joshfriend/wwvb_shield/EAGLE/Layout.jpg

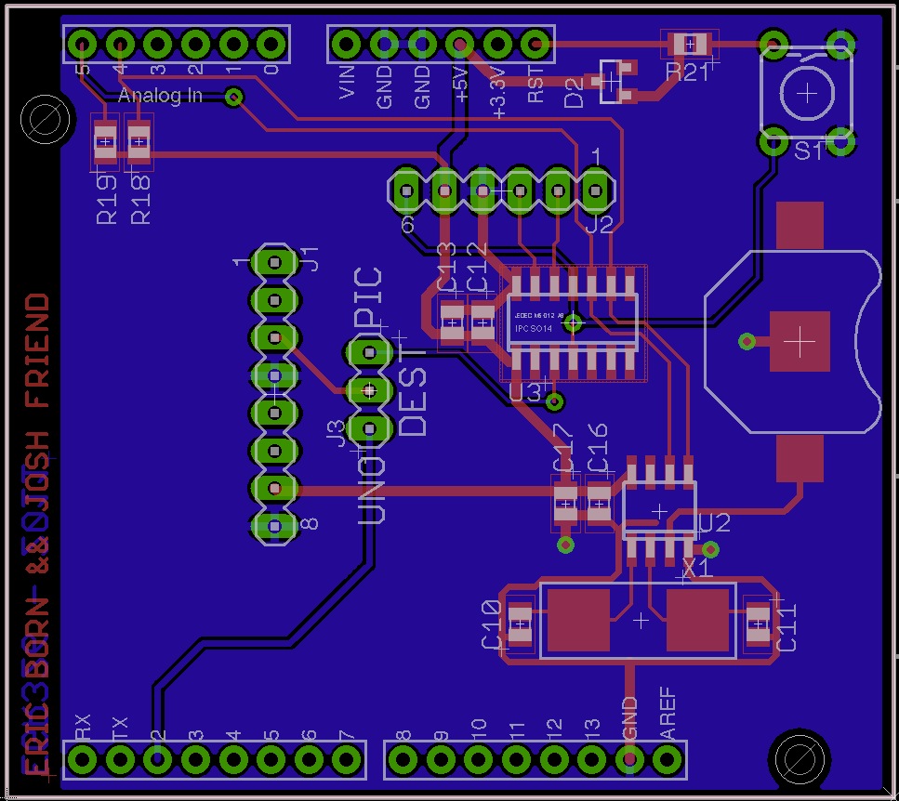
EAGLE/Layout.jpg
