joshfriend/wwvb_shield/README

This is the GIT repository for the Atomic Clock Arduino Shield created by Eric Born and Josh Friend for the EGR326 Junior Design Project at GVSU School of Engineering.

This repo contains all EAGLE schematic and board files as well as GERBERs and source code files used in the project.
