joshfriend/wwvb_shield/BOM/WWVB Shield BOM.xlsx

EGR326 - 901
WWVB Receiver Shield BOM
Internal Components
Eric Born and Josh Friend
REVISION B02
Description | Manufacturer | MFR PN | Vendor | Vendor PN | Package Type | REFDES | QTY | Unit Price (QTY1) | Total Cost (QTY 1) | Notes | Datasheet
IC MCU 8BIT FLASH 14SOIC | Microchip | PIC16F1823-I/SL | DigiKey | PIC16F1823-I/SL-ND (http://search.digikey.com/us/en/products/PIC16F1823-I%2FSL/PIC16F1823-I%2FSL-ND/2258580) | SOIC | U1 | 1 | $1.38 | $1.38 |  | http://ww1.microchip.com/downloads/en/DeviceDoc/41413B.pdf
IC RTCC 64B SRAM GP 8-SOIC | Microchip | MCP7940N | DigiKey | MCP7940N-I/SN-ND (http://search.digikey.com/scripts/DkSearch/dksus.dll?Detail&name=MCP7940N-I/SN-ND) | SOIC | U2 | 1 | $1.04 | $1.04 |  | http://ww1.microchip.com/downloads/en/DeviceDoc/25010B.pdf
HOLDER COIN CELL 12MM SMD | MPD | BK-885-TR | DigiKey | BK-885CT-ND (http://search.digikey.com/us/en/products/BK-885-TR/BK-885CT-ND/755448) | SMD | BAT1 | 1 | $0.48 | $0.48 |  | http://www.memoryprotectiondevices.com/datasheets/BK-885-datasheet.pdf (http://www.onsemi.com/pub_link/Collateral/MMBF4391LT1-D.PDF)
DIODE SCHOTTKY 200MA 30V SOT-23 | Comchip | BAT54-G | DigiKey | 641-1321-1-ND (http://search.digikey.com/us/en/products/BAT54-G/641-1321-1-ND/1979686) | SOT-23 | D1 | 1 | $0.35 | $0.35 |  | http://comchipt.ipower.com/docs/BAT54.pdf
CRYSTAL 32.7680KHZ 12.5PF SMD | Epson | MC-405 32.7680K-A0:ROHS | DigiKey | SER2405CT-ND (http://search.digikey.com/us/en/products/MC-405%2032.7680K-A0:ROHS/SER2405CT-ND/1532561) | SMD | X1 | 1 | $1.01 | $1.01 |  | http://media.digikey.com/pdf/Data%20Sheets/Epson%20PDFs/MC-306%20,405,%20406.pdf
SPST Mini Pushbutton TH | Omiron | (unknown) | SparkFun | COM-00097 (http://www.sparkfun.com/products/97) | TH | S1 | 1 | $0.35 | $0.35 |  | http://www.sparkfun.com/datasheets/Components/General/00097.jpg
CONN HEADER VERT 3POS .100 TIN | TE Connectivity | 3-644456-3 | DigiKey | A31113-ND (http://search.digikey.com/us/en/products/3-644456-3/A31113-ND/698345) | TH | J3 | 1 | $0.22 | $0.22 |  | http://documents.tycoelectronics.com/commerce/DocumentDelivery/DDEController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
CONN HEADER 6POS .100 R/A TIN | FCI | 68016-406HLF | DigiKey | 609-3327-ND (http://search.digikey.com/us/en/products/68016-406HLF/609-3327-ND/1878461) | TH | J2 | 1 | $0.41 | $0.41 |  | http://portal.fciconnect.com/res/en/pdffiles/doc_search/68015.pdf
CONN FEMALE 8POS .100" R/A TIN | Sullins Con. Solns. | PPTC081LGBN-RC | DigiKey | S5444-ND (http://search.digikey.com/us/en/products/PPTC081LGBN-RC/S5444-ND/775902) | TH | J4 | 1 | $0.90 | $0.90 |  | http://www.sullinscorp.com/drawings/78_P(N)PxCxx1LGBN-RC,_10493-F.pdf
Arduino Stackable Header Kit | (unknown) | (unknown) | SparkFun | PRT-10007 (http://www.sparkfun.com/products/10007) | TH | J1 | 1 | $1.50 | $1.50 |  | http://www.sparkfun.com/datasheets/Prototyping/Connectors/18688.pdf
RES 4.7K OHM 1/8W 1% 0805 SMD | Panasonic | ERJ-6ENF4701V | DigiKey | P4.70KCCT-ND (http://search.digikey.com/us/en/products/ERJ-6ENF4701V/P4.70KCCT-ND/1746872) | 0805 | R3 | 1 | $0.07 | $0.07 |  | http://industrial.panasonic.com/www-data/pdf/AOA0000/AOA0000CE2.pdf
RES 10.0K OHM 1/8W 1% 0805 SMD | Panasonic | ERJ-6ENF1002V | DigiKey | P10.0KCCT-ND (http://search.digikey.com/us/en/products/ERJ-6ENF1002V/P10.0KCCT-ND/119248) | 0805 | R1, R2 | 2 | $0.07 | $0.14 |  | http://industrial.panasonic.com/www-data/pdf/AOA0000/AOA0000CE2.pdf
CAP CER 10PF 50V 5% NP0 0805 | Johanson Dielectric | 500R15N100JV4T | DigiKey | 709-1168-1-ND (http://search.digikey.com/us/en/products/500R15N100JV4T/709-1168-1-ND/1859500) | 0805 | C5, C6 | 2 | $0.04 | $0.09 |  | http://www.johansondielectrics.com/images/stories/surface-mount/smt-mlc/JDI_Surface-Mount_2008-11.pdf
CAP CER 10000PF 50V 10% X7R 0805 | AVX | 08055C103KAT2A | DigiKey | 478-1383-1-ND (http://search.digikey.com/us/en/products/08055C103KAT2A/478-1383-1-ND/564415) | 0805 | C3, C4 | 2 | $0.03 | $0.06 |  | http://www.avx.com/docs/Catalogs/cx7r.pdf
CAP CER 0.1UF 50V Y5V 0805 | Yageo | CC0805ZRY5V9BB104 | DigiKey | 311-1361-1-ND (http://search.digikey.com/us/en/products/CC0805ZRY5V9BB104/311-1361-1-ND/2103145) | 0805 | C1, C2 | 2 | $0.04 | $0.08 |  | http://media.digikey.com/pdf/Data%20Sheets/Yageo%20PDFs/MLCC%20ordering%20code.pdf
PCB | Advanced Circuits |  | Adv. Ckts. | - | - | - | 1 | $5.00 | $5.00
 |  |  |  |  |  |  |  | Total | $13.07
EGR326 - 901
WWVB Receiver Shield BOM
External Components
Eric Born and Josh Friend
REVISION B02
Description | Manufacturer | MFR PN | Vendor | Vendor PN | Package Type | REFDES | QTY | Unit Price (QTY100) | Total Cost (QTY 100) | Notes | Datasheet
CMAX WWVB Reciever | C-MAX Time | CMMR-6P-60 | DigiKey | 561-1014-ND (http://search.digikey.com/us/en/products/CMMR-6P-60/561-1014-ND/761973) | TH | - | 1 | $6.69 | $6.69 |  | http://www.c-max-time.com/downloads/getFile.php?id=542
 |  |  |  |  |  |  |  | Total | $6.69
 |  |  |  |  |  |  |  | GRAND TOTAL | $19.76
