joshfriend/wwvb_shield/EAGLE/WWVB Shield Schematic.pdf

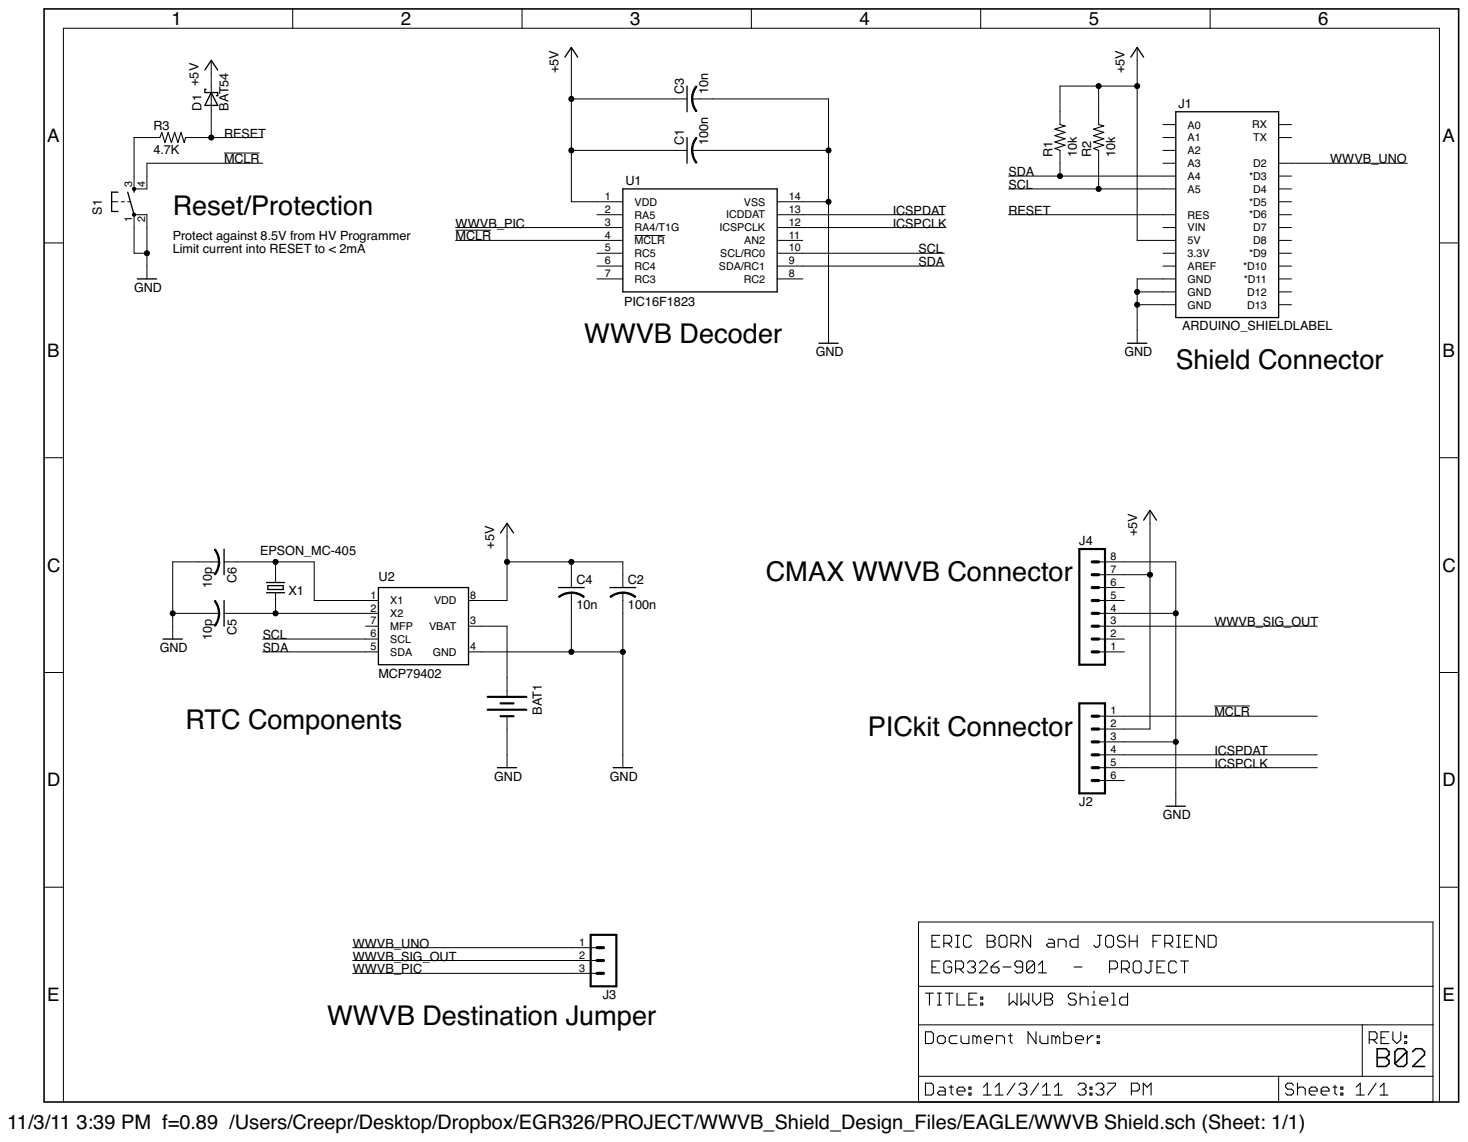
[picture p6: page 1]

Protect against 8.5V from HV Programmer Limit current into RESET to < 2mA

11/3/11 3:39 PM f=0.89 /Users/Creepr/Desktop/Dropbox/EGR326/PROJECT/WWVB_Shield_Design_Files/EAGLE/WWVB Shield.sch (Sheet: 1/1)
