joshfriend/wwvb_shield/CODE/Arduino Sketches/RTC_read/RTC_read.pde

// Date and time functions using a MCP79410N RTC connected via I2C and Wire lib

#include <Wire.h>
#include "RTClib.h"

RTC Clock;

void setup () {
    Serial.begin(9600);
    Wire.begin();
    Clock.begin();
    Clock.set_vbaten(0x01);
    //Clock.adjust(DateTime(__DATE__, __TIME__));
     
    /*
    if (! Clock.isrunning()) {
        Serial.println("RTC is NOT running!");
        // following line sets the RTC to the date & time this sketch was compiled
        Clock.adjust(DateTime(__DATE__, __TIME__));
    }*/
}

void loop () {
    
    DateTime now = Clock.now();
    
    Serial.print(now.year(), DEC);
    Serial.print('/');
    Serial.print(now.month(), DEC);
    Serial.print('/');
    Serial.print(now.day(), DEC);
    Serial.print(' ');
    Serial.print(now.hour(), DEC);
    Serial.print(':');
    Serial.print(now.minute(), DEC);
    Serial.print(':');
    Serial.print(now.second(), DEC);
    Serial.println();
    
    Serial.println();
    delay(1000);
}
