joshfriend/wwvb_shield/(commit log)

2011-10-22 Added pdf of the EAGLE schematic
2011-10-22 updated README and uploaded Bill of Materials"
    [WWVB Shield BOM.xlsx]
2011-10-25 moved all components to top side
    [WWVB Shield.brd, WWVB Shield.sch]
2011-10-25 added mounting hole for antenna (1/8th inch), moved opamp decoupling closer to chip, routed coin cell ground, resized lettering to pass DRC.
    [WWVB Shield.brd, WWVB Shield.sch]
2011-10-25 updated schematic PDF
    [WWVB Shield.sch]
2011-10-26 flipped J1 back to top side of the board. all componenents on top side now (really!)
    [WWVB Shield.brd, WWVB Shield.sch]
2011-10-26 Added reset protection for Arduino against high voltage programming via MCLR.
    [WWVB Shield.brd, WWVB Shield.sch]
2011-10-26 added description of reset protection
    [WWVB Shield.sch]
2011-10-27 updated BOM with reference designators.
    [WWVB Shield BOM.xlsx, WWVB Shield.brd, WWVB Shield.sch]
2011-10-27 added test GERBER files, CAM Processor setup file, and GerbV project settings file
    [WWVB Shield.brd, WWVB Shield.sch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]
2011-10-29 added WWVB test code for arduino found online. also added initial stab at creating WWVB decoder algorithms and date functions.
2011-11-02 Updated BOM to include pricing with and without our radio and CMAX radio
    [WWVB Shield BOM.xlsx]
2011-11-03 revised BOM to separate onboard and external parts, updated reference designators and quantities
    [WWVB Shield BOM.xlsx]
2011-11-03 tweaked layout silkscreen, renumbered reference designators on Schematic
    [WWVB Shield.brd, WWVB Shield.sch]
2011-11-06 added I2C comms library and RTC library, updated others
2011-11-06 updated BOM for design review
    [WWVB Shield BOM.xlsx]
2011-11-06 Tweaked schematic and layout silk after design review. now shows xtal frequency and battery voltage on schematic.
    [WWVB Shield.brd, WWVB Shield.sch]
2011-11-10 Updated CAM settings, Made PCB 1/4 inch larger to allow for space for antenna mounting hole. Fixed pad sizes on battery holder. Tweaked silkscreen
    [WWVB Shield.brd, WWVB Shield.sch]
2011-11-11 Updated GERBERS that will be used in board manufacturing
    [BOTTOM_COPPER.GBL, BOTTOM_MASK.GBS, TOP_COPPER.GTL, TOP_MASK.GTS, TOP_SILK.GTO]
2011-11-11 updated CAM settings file and Board Layout for final GERBER processing
    [WWVB Shield.brd]
2011-11-11 Fixed soldermask issue where vias were covered
    [WWVB Shield.brd]
2011-11-11 New gerbers with soldermask relief on all vias
    [BOTTOM_MASK.GBS, TOP_MASK.GTS]
2011-11-11 cleaned up uneccesary files
    [BOTTOM_SILK.GBO]
2011-11-13 Added shield hardware header file, got I2C library working (write to slave at least)
2011-11-18 Got I2C library working with buffers and interrupts"
2011-11-24 added Arduino sketch to adjust for timezones
2011-11-27 updated simulator to recieve I2C debug data
2011-12-02 fixed date calculation problem
    [Main.c, calendar.c, types.h, wwvb.c]
2011-12-06 updated LUT for dont care bits to include DUT and leapsecond since these are not used. Also added code to clear frame data when resetting to position 0.
    [wwvb.c, wwvb.h]
2011-12-06 added more code to clear frame buffer when re-syncing position
2011-12-06 added debugging sketch for arduino
2011-12-07 added a modified version of the Adafruit RTClib Arduino library. Has been modified to work with our microchip RTC.
2011-12-08 deleted excel temp file from BOM folder
2011-12-08 switched back to non interrupt I2C transmission since buffered method seemed to be sending wrong values. Adding 1 to minutes now since WWVB transmits current minute which is over by the time transmis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
    [Main.c, wwvb.c, wwvb.h]
2011-12-08 updated debug code for cleaner output. updated status LED operation to show results of validation check when not connected to serial monitor
2011-12-09 added check to make sure that frame bits with a value of 2 dont pass intinto the algorithm and get added to a time variable. only binary 1/0 should pass through to this area.
2011-12-09 added missing transmission of register pointer for RTC
    [Main.c]
2011-12-09 updated arduino library for RTC with UTC offset function
